AlexGerUA/retro-console-esp32s3/docs/parts/display.png

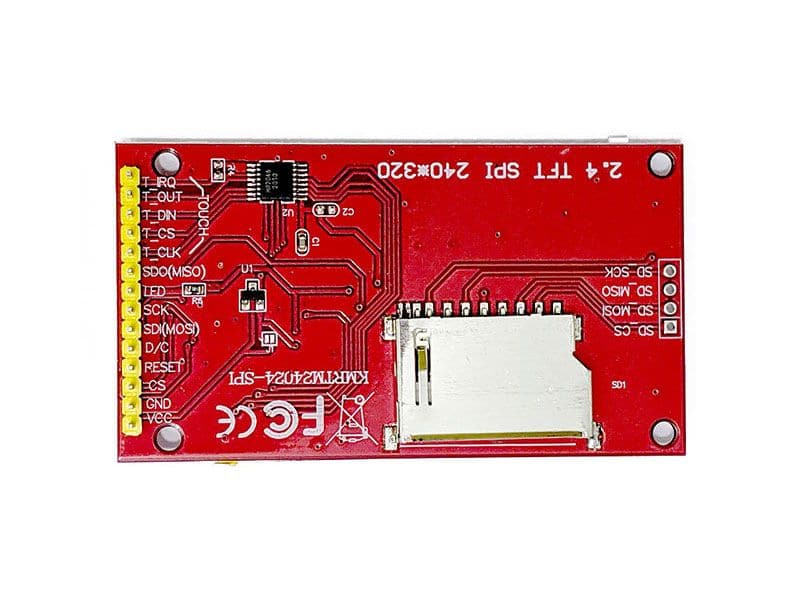
docs/parts/display.png
