AlexGerUA/retro-console-esp32s3/docs/parts/esp32s3.png

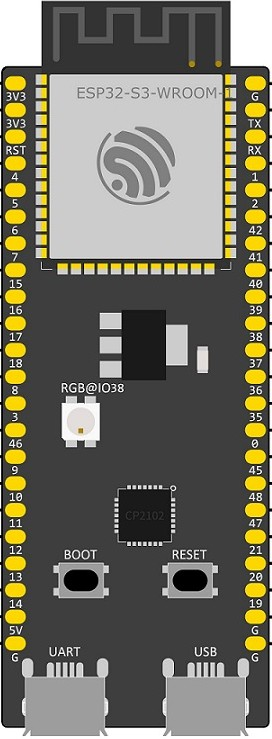
docs/parts/esp32s3.png
