AlexGerUA/retro-console-esp32s3/docs/parts/max98357a.png

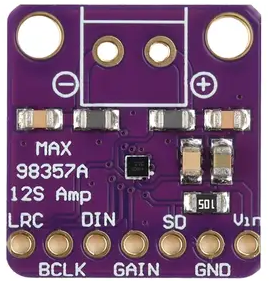
docs/parts/max98357a.png
