AlexGerUA/retro-console-esp32s3/docs/parts/tp4056.png

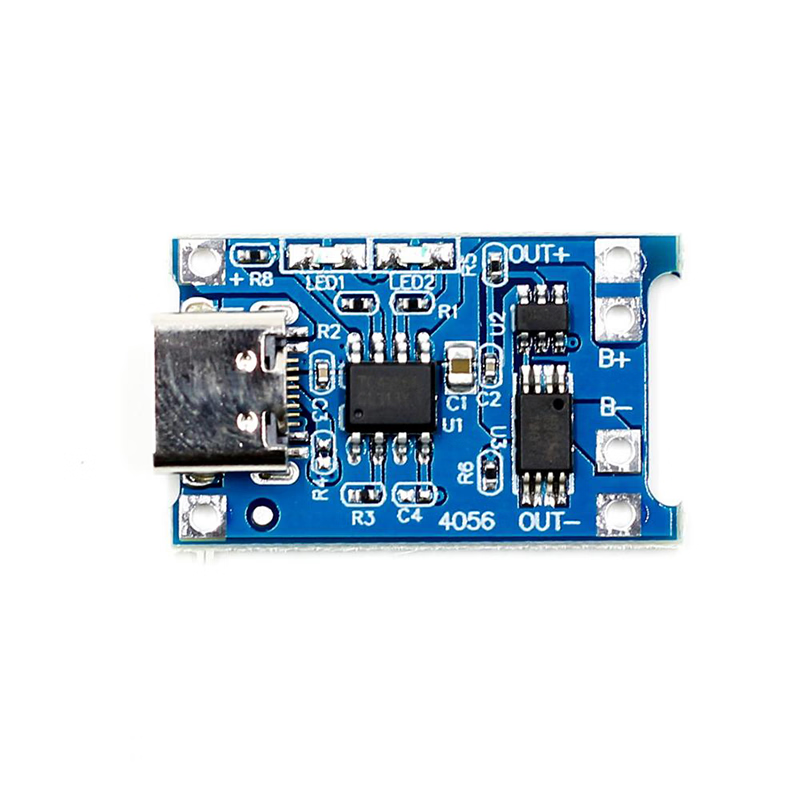
docs/parts/tp4056.png
