AlexGerUA/retro-console-esp32s3/docs/parts/xl6009.png

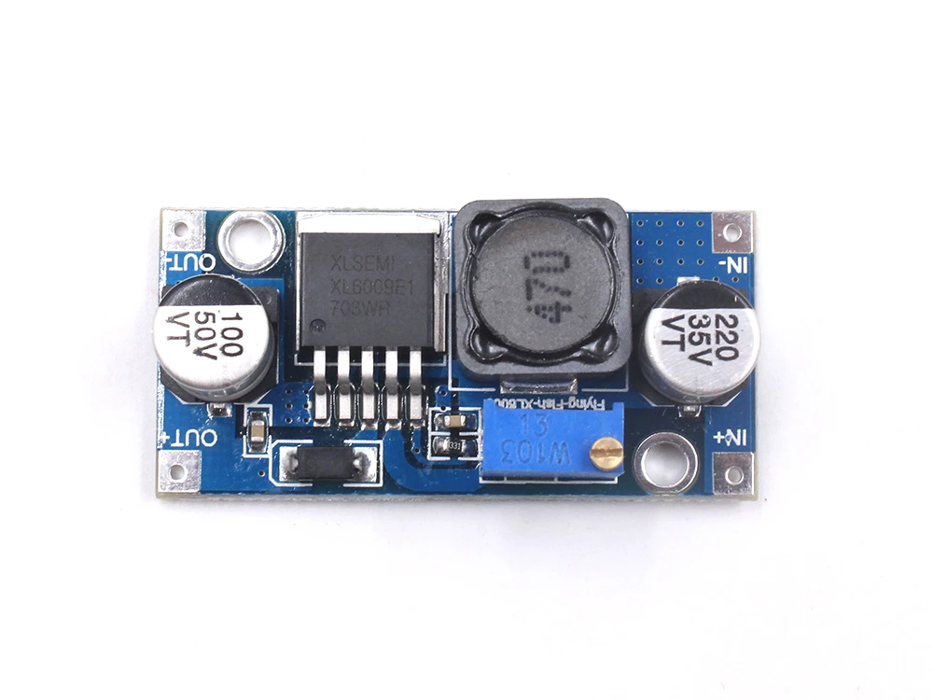
docs/parts/xl6009.png
