AlexGerUA/retro-console-esp32s3/3d/Back.stl

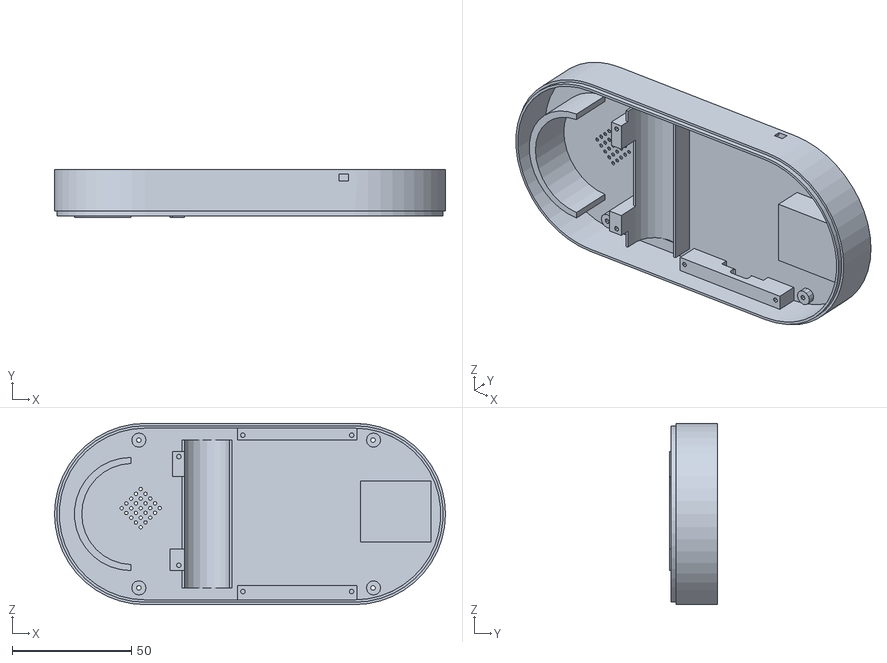
[picture p11: CAD file, 2026-11-10]
3d/Back.stl
164.0 x 20.2 x 76.0
