AlexGerUA/retro-console-esp32s3/3d/Cover.stl

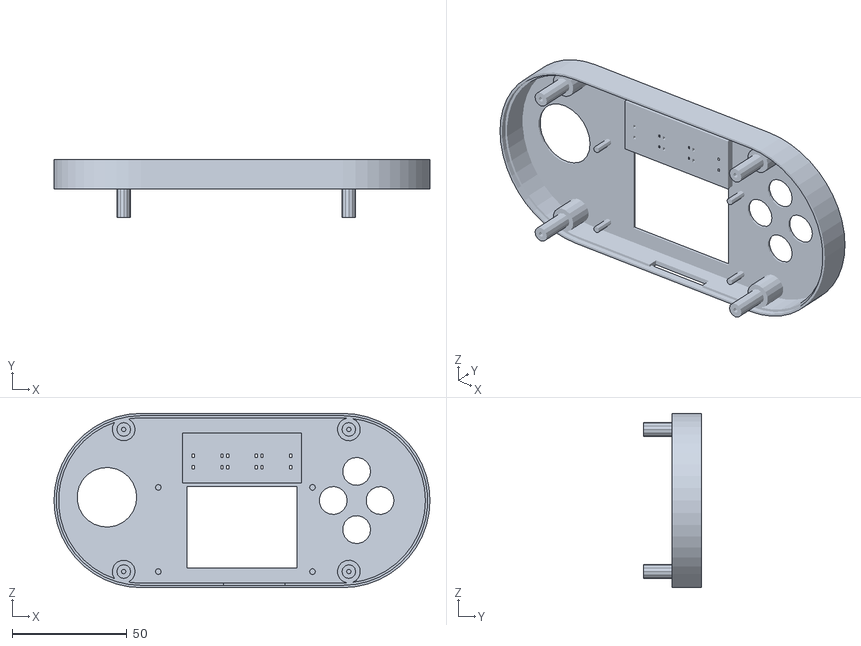
[picture p12: CAD file, 2026-11-10]
3d/Cover.stl
164.0 x 25.5 x 76.0
