AlexGerUA/retro-console-esp32s3/(commit log)

2026-11-10 Retro console on ESP32-S3: Retro-Go target, case STL, wiring
    [Back.stl, Cover.stl]
2026-11-10 Pinout in DevKitC style with colour tags and pull-up/divider/power schematics
2026-11-10 Pinout redrawn as a bench wiring diagram: modules, dupont wires, pull-up and divider
2026-11-10 Pinout: full wiring diagram with module photos, every resistor and capacitor
2026-11-10 Pinout: drop button capacitors
2026-11-10 Pinout: decoupling caps 470uF + 100nF on 5V and 3V3 inputs
2026-11-10 README: full bill of materials
2026-11-12 Pinout: pull-up resistor on the signal wire, button from the wire to GND
    Why: in the old diagram the 10k pull-up went to one leg of the tact switch
    and the GPIO wire to another leg. The pull-up then reached the GPIO only
    through the button's internal leg pair, so the circuit depended on which
    legs of a particular 4-leg switch are joined inside. Turn the button 90
    degrees and it reads "pressed" forever, or the GPIO floats.
    Now (same as the Bruce Smoochie board): 10k goes from 3V3 straight onto the
    signal wire that runs to the GPIO, and the button hangs off that same wire
    to GND, using diagonal legs (a diagonal pair is always the switched pair).
    Works with any button type and any orientation.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
2026-11-12 Bilingual docs: English README.md + Ukrainian README.uk.md with a language switcher
    - README.md is now the full English version (before it was only a short
    summary at the bottom), README.uk.md holds the Ukrainian text.
    - Both files start with an English | Українська switcher.
    - docs/make_pinout.py renders the wiring diagram in both languages:
    docs/pinout.png (Ukrainian) and docs/pinout_en.png (English).
    [make_pinout.py]
